feudas/SUN-DAC-Control/images2/1.jpeg

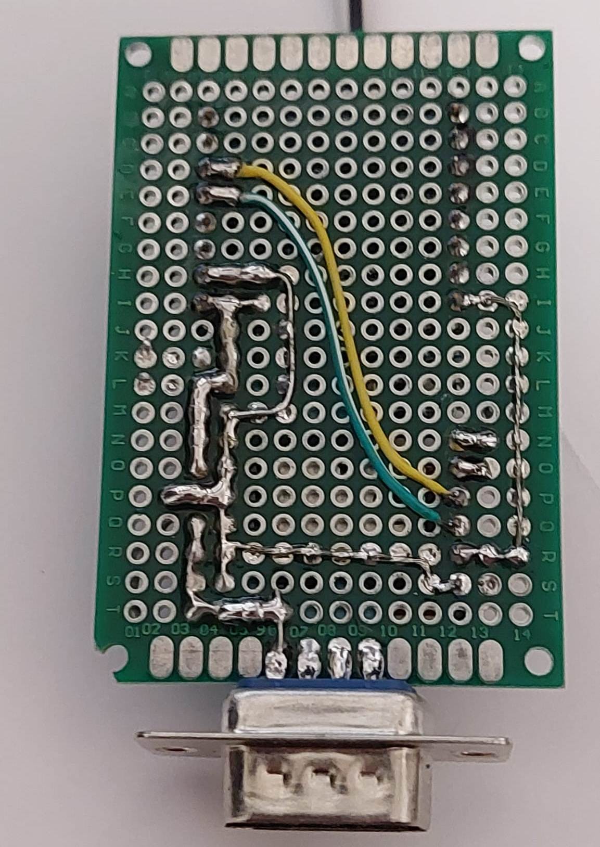
images2/1.jpeg
