feudas/SUN-DAC-Control/images2/2.jpeg

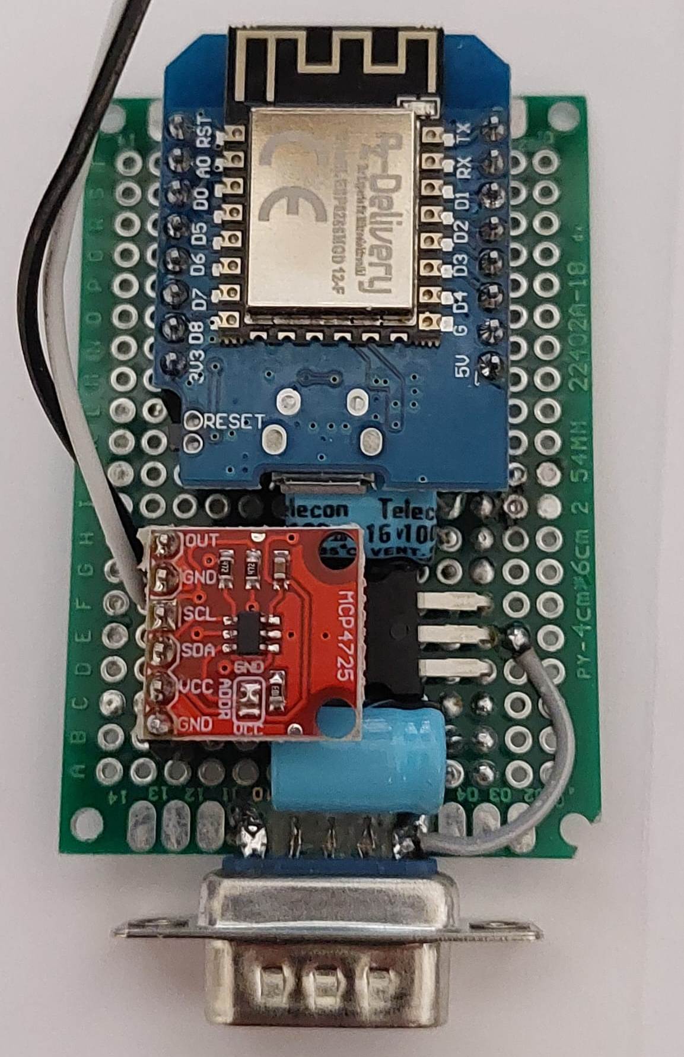
images2/2.jpeg
