feudas/SUN-DAC-Control/images2/3.jpeg

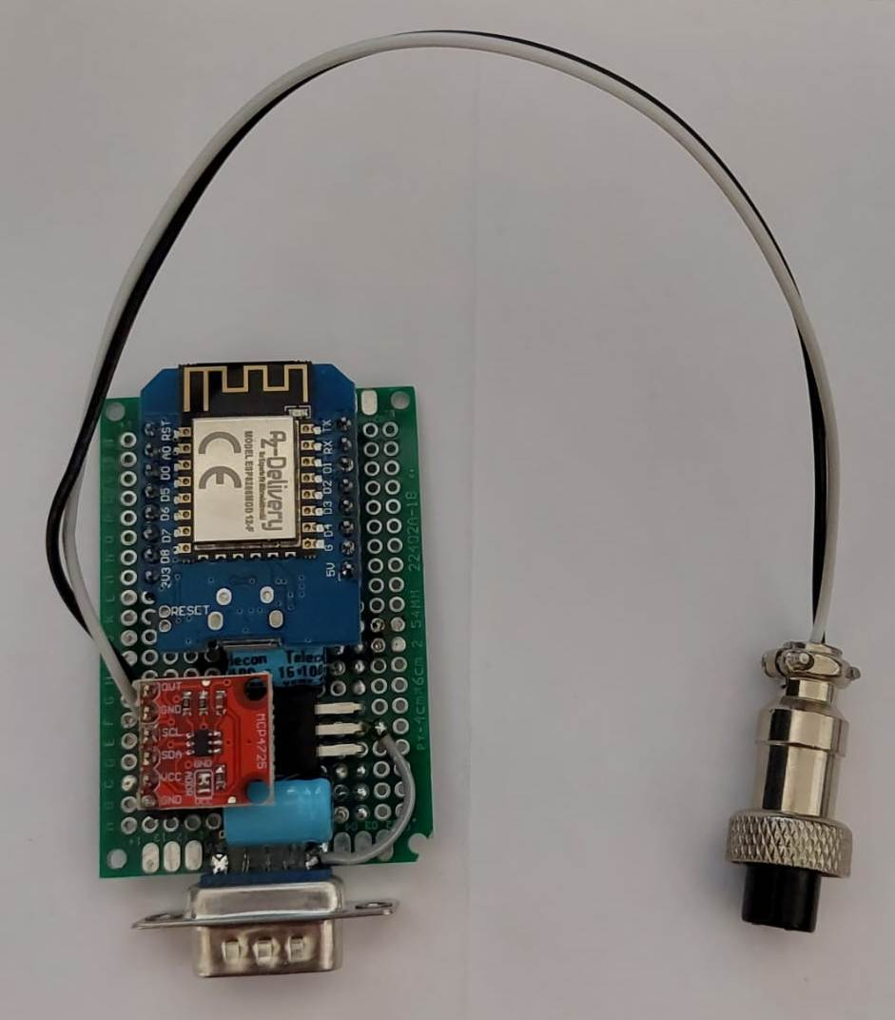
images2/3.jpeg
