feudas/SUN-DAC-Control/images2/4.jpeg

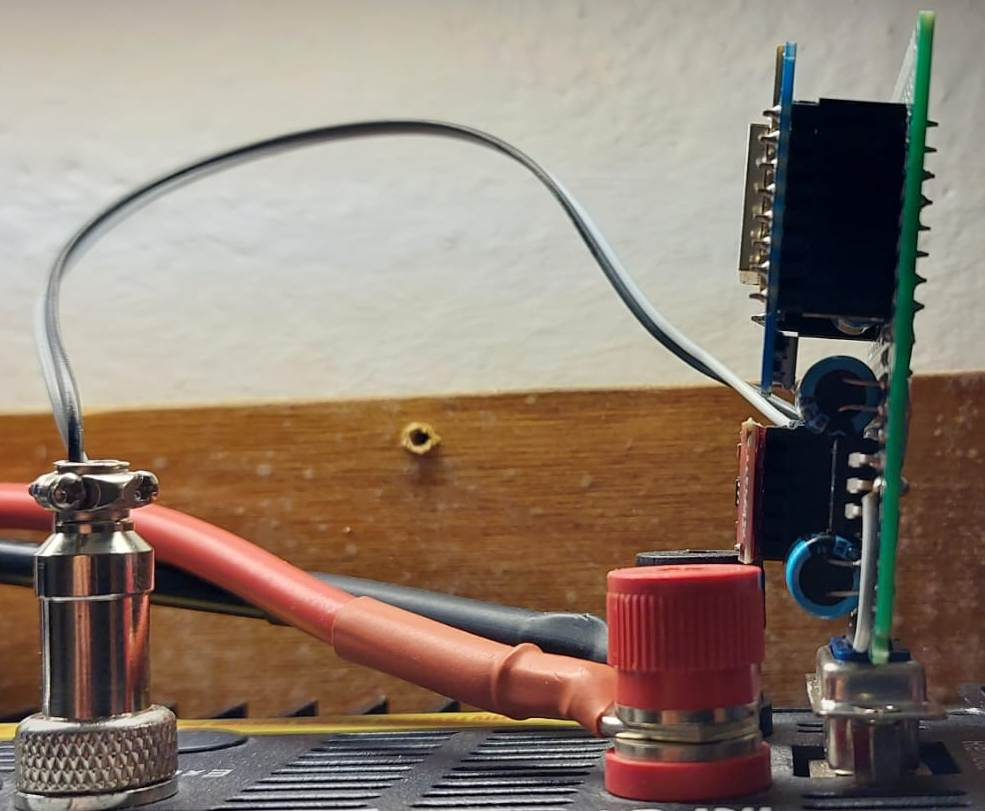
images2/4.jpeg
